TheZeta/antagonistic-joint-sim2real/docs/figures/control_comparison.png

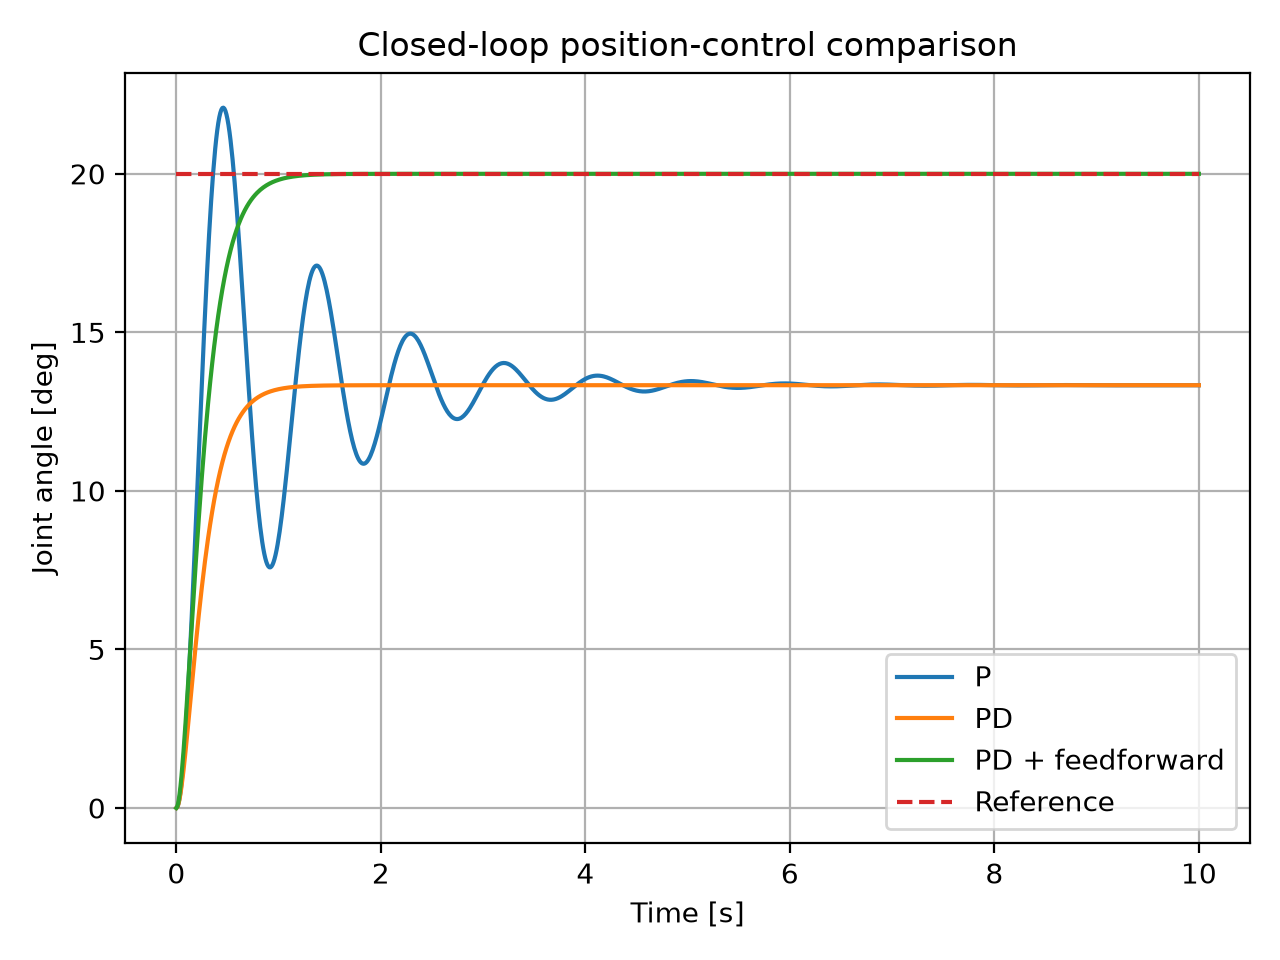
docs/figures/control_comparison.png
