TheZeta/antagonistic-joint-sim2real/docs/figures/model_mismatch_sweep.png

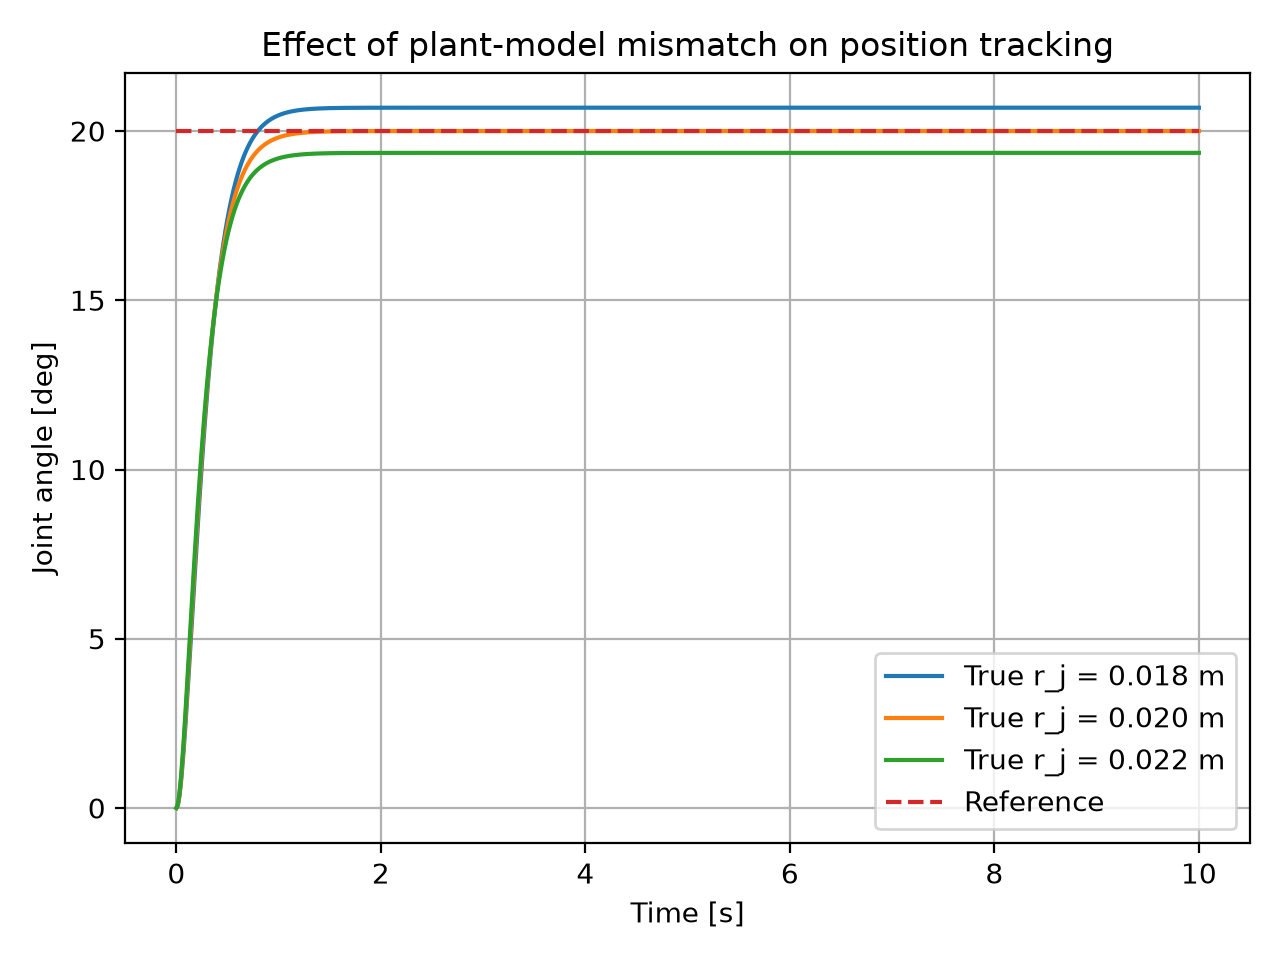
docs/figures/model_mismatch_sweep.png
