TheZeta/antagonistic-joint-sim2real/hardware/cad/h0_antagonistic_joint_assembly.stp

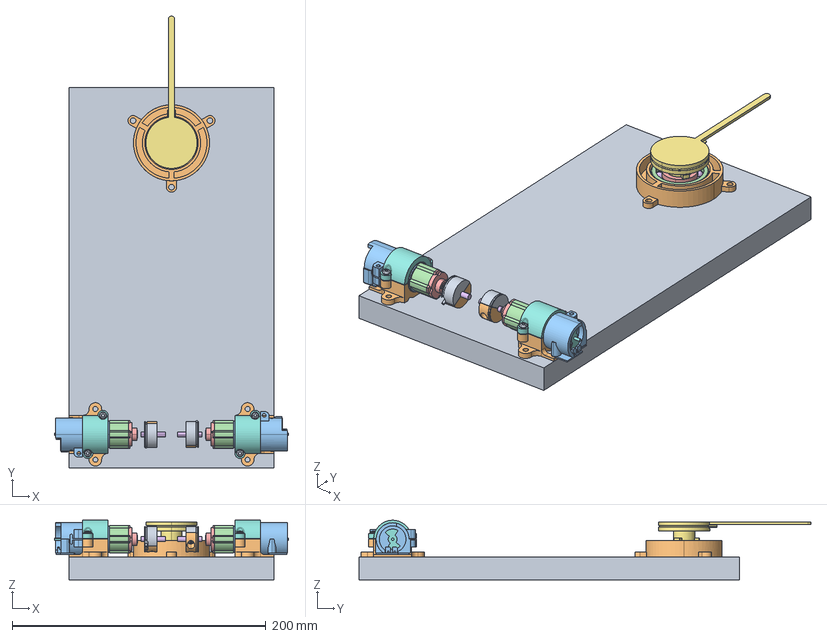
[picture p13: CAD file, 2026-10-17]
hardware/cad/h0_antagonistic_joint_assembly.stp
184.6 x 356.5 x 47.0 mm
GROUND_PLATE
MOTOR_HOUSING_BOTTOM x 2
CORTAR-EXTRUIR13 x 2
CORTAR-EXTRUIR5100 x 2
CORTAR-EXTRUIR5300 x 2
PREDETERMINADO x 4
KASNAK_BINDIRME x 2
KASNAK_KAPATMA x 2
6203_OUTER_RING
6203_INNER_RING
6203_BALL x 10
CENTER_SHAFT
MOTOR_HOUSING_TOP x 2
SPIDER
AS5600_MAGNETIC_ENCODER
MAGNET
