TheZeta/antagonistic-joint-sim2real/(commit log)

2026-09-04 Implement antagonistic joint model v0
2026-09-07 Add stiffness sensitivity experiment
    [sweep_stiffness.cpp]
2026-09-07 Test preload invariance of joint dynamics
2026-10-08 Add H0 calibration and coordinate mappings
2026-10-08 Add H0 host-device protocol
2026-10-09 Add H0 dry-run device core
2026-10-11 Add H0 single-motor position servo
2026-10-12 Enable bounded H0 single-motor motion
2026-10-13 Replace H0 pulse drive with hardware PWM
2026-10-14 Add damped H0 motor position servo
2026-10-16 Validate H0 Model v1 on relaxation probe
2026-10-17 Present H0 sim2real results and hardware CAD
